BecsterAS/PowerLineSensorPCB/PowerLineSensorPCB.kicad_pcb

## KiCad design PowerLineSensorPCB.kicad_pcb (2026-07-15)

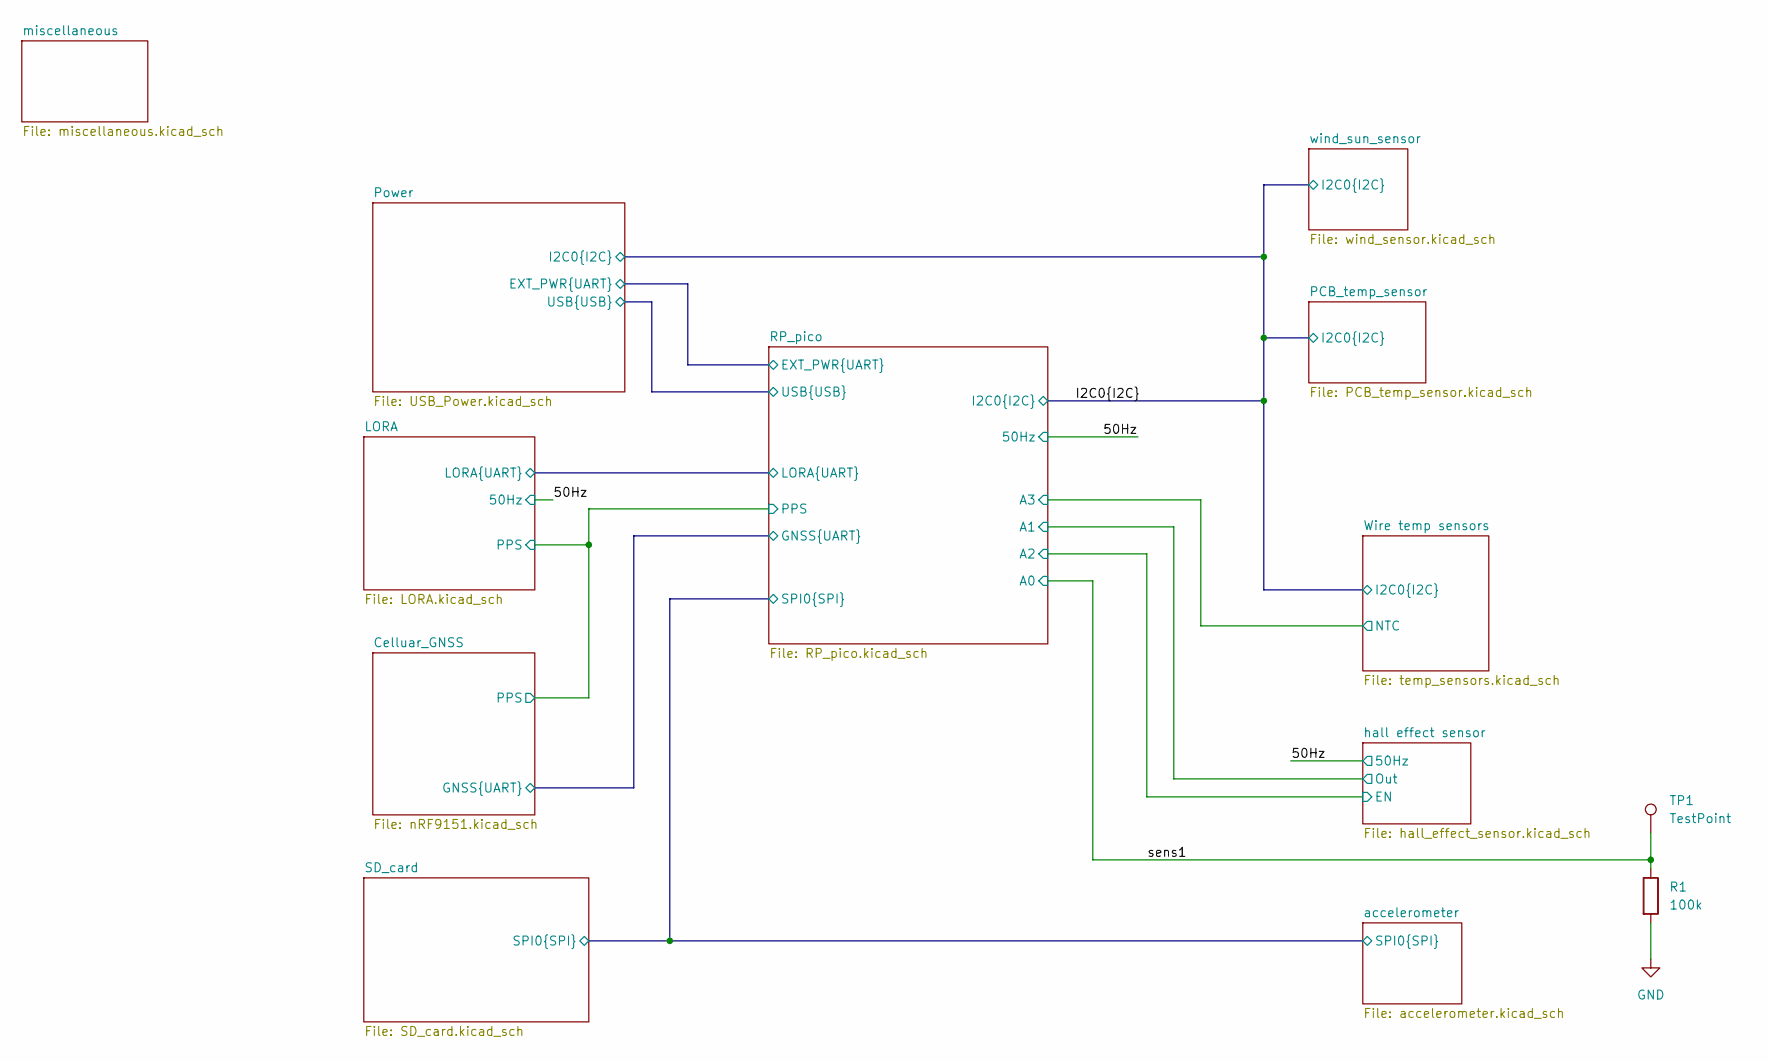
[picture p1: schematic PowerLineSensorPCB.kicad_sch]

Parts:
R1: 100k; R_0402_1005Metric; PartNumber 0402WGF1003TCE
TP1: TestPoint; TestPoint_Pad_D1.0mm

Connections:
/sens1: R1.1, TP1.1 (1_1); also elsewhere on the board
GND: R1.2; also elsewhere on the board

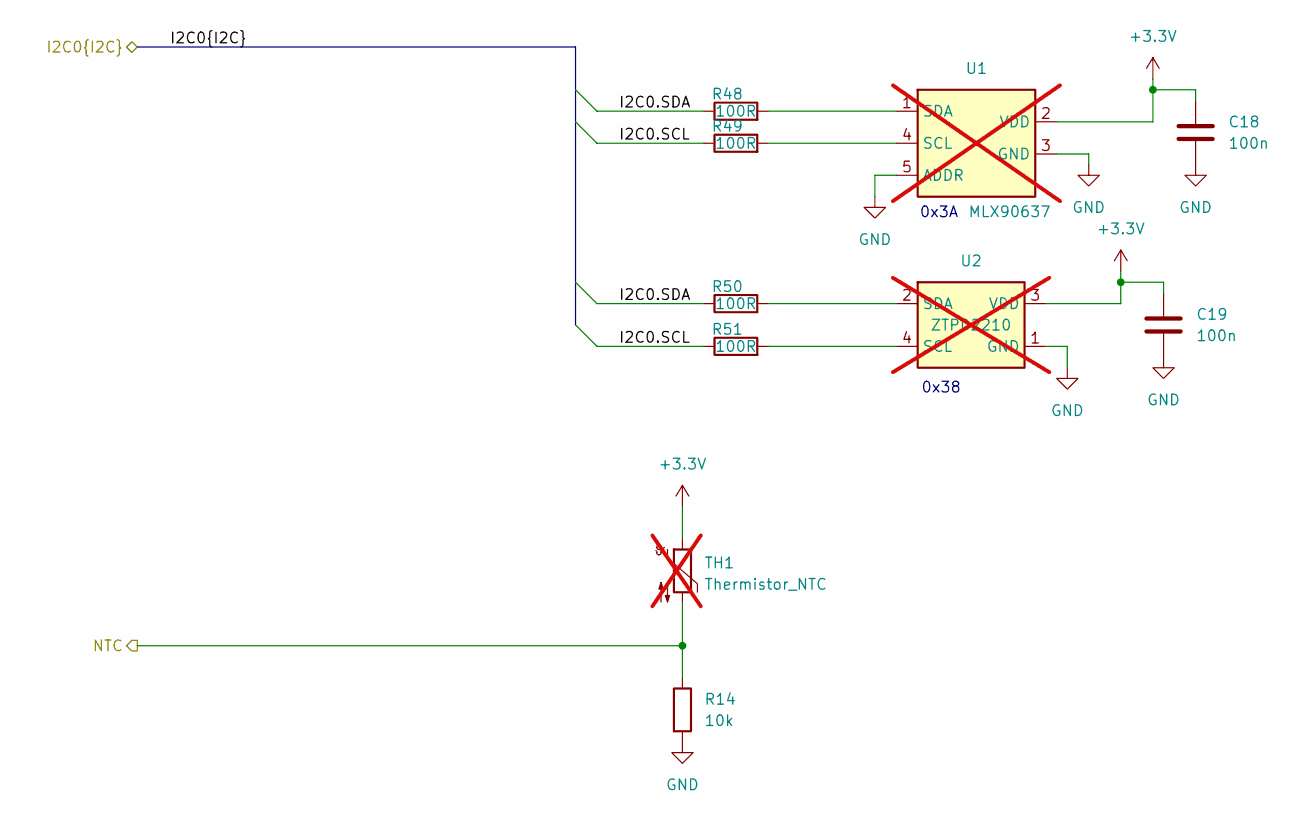
[picture p2: schematic temp_sensors.kicad_sch]

Parts:
C18, C19: 100n; C_0402_1005Metric; PartNumber CL05B104KO5NNNC
R14: 10k; R_0402_1005Metric; PartNumber 0402WGF1002TCE
R48, R49, R50, R51: 100R; R_0402_1005Metric; PartNumber 0402WGF1000TCE
TH1: Thermistor_NTC; R_Axial_DIN0204_L3.6mm_D1.6mm_P2.54mm_Vertical; not fitted
U1: MLX90637; PartNumber MLX90637; not fitted
U2: ZTPD2210; PartNumber ZTPD2210; not fitted

Connections:
+3.3V: C18.1, C19.1, TH1.1, U1.2 (VDD), U2.3 (VDD); also elsewhere on the board
/I2C0.SCL: R49.1, R51.1; also elsewhere on the board
/I2C0.SDA: R48.1, R50.1; also elsewhere on the board
/RP_pico/A3: R14.1, TH1.2; also elsewhere on the board
GND: C18.2, C19.2, R14.2, U1.3 (GND), U1.5 (ADDR), U1.6 (GND), U2.1 (GND); also elsewhere on the board
unnamed: R49.2, U1.4 (SCL)
unnamed: R48.2, U1.1 (SDA)
unnamed: R51.2, U2.4 (SCL)
unnamed: R50.2, U2.2 (SDA)

Notes on the sheet:
0x38
0x3A

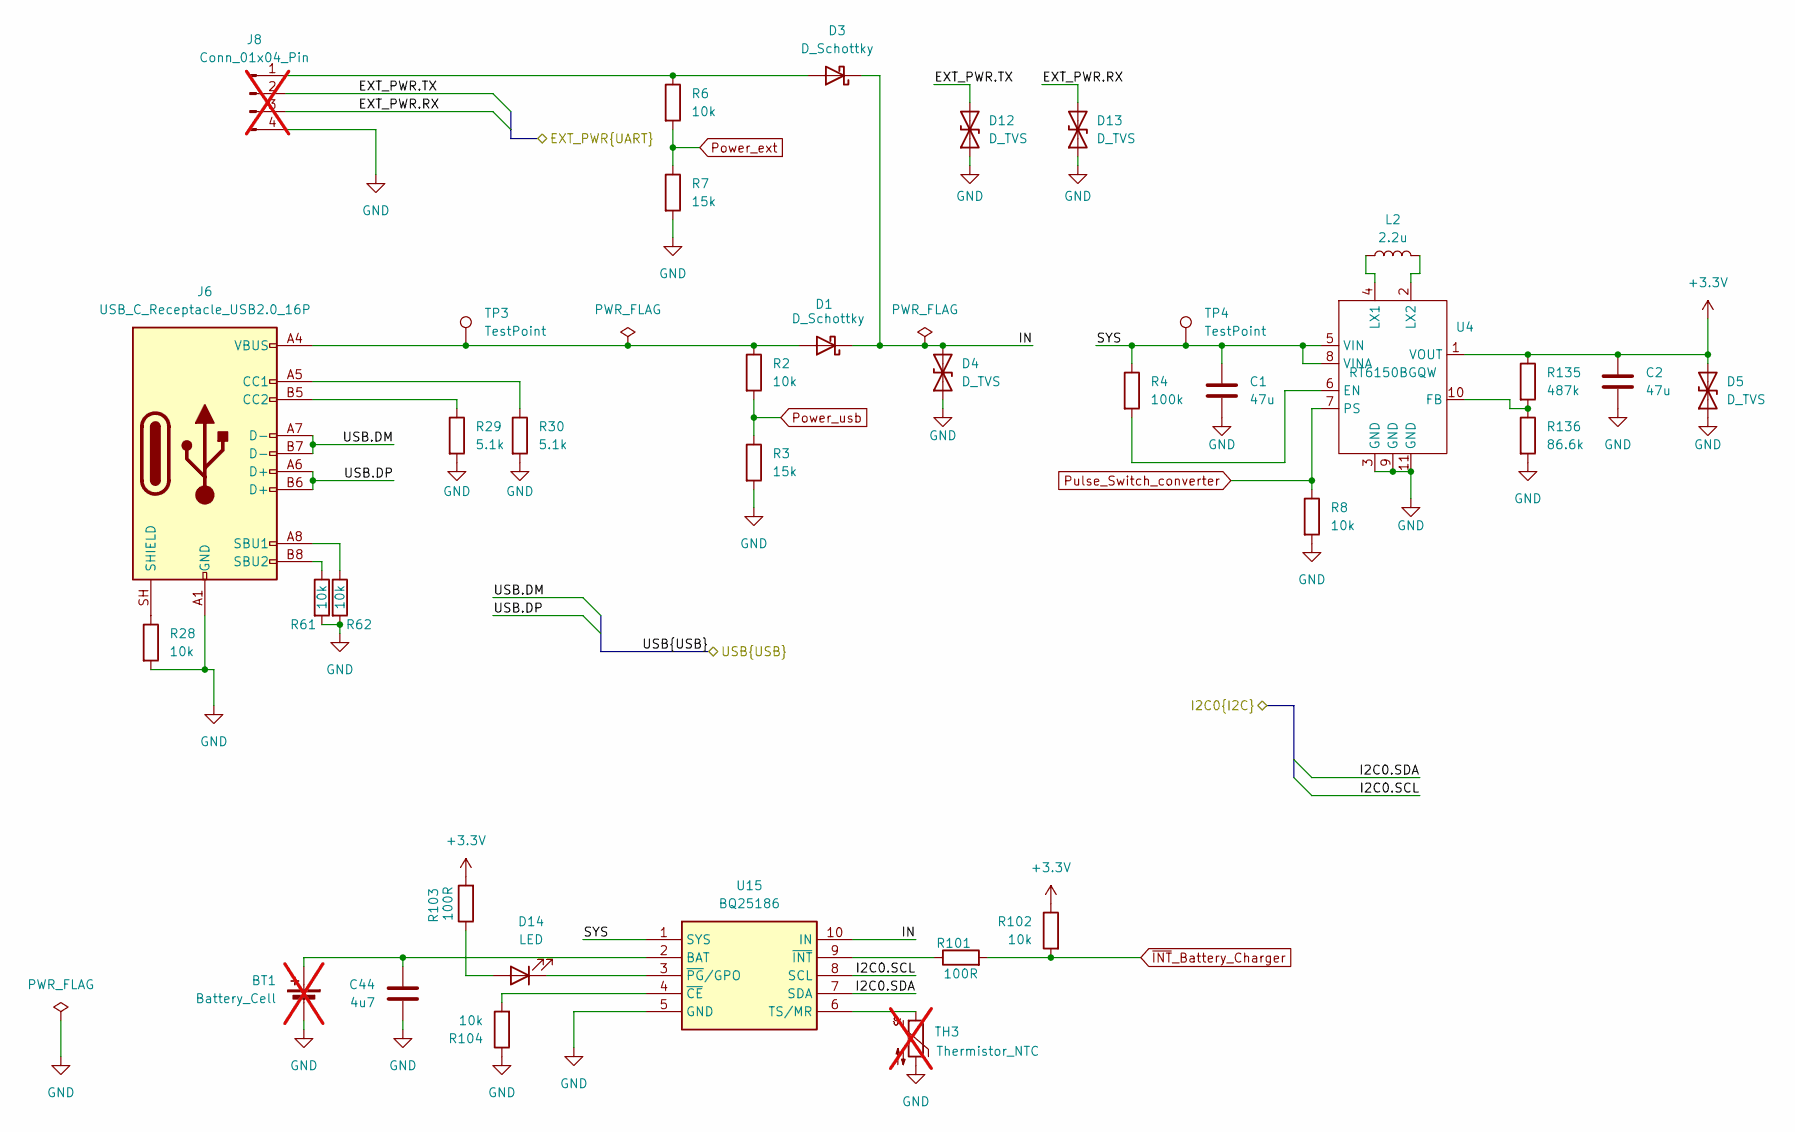
[picture p3: schematic USB_Power.kicad_sch]

Parts:
BT1: Battery_Cell; BatteryHolder_MPD_BH-18650-PC; PartNumber BH-18650-PC; not fitted
C1, C2: 47u; C_1206_3216Metric; PartNumber CL31A476MPHNNNE
C44: 4u7; C_0402_1005Metric; PartNumber CL05A475MP5NRNC
D1, D3: D_Schottky; D_SMA; PartNumber SS210
D4: D_TVS; D_SMB; PartNumber P6SMB6.8CA/TR13
D5, D12, D13: D_TVS; D_SOD-882; PartNumber PESD5V0C1ULS-QYL
D14: LED; D_0603_1608Metric; PartNumber KT-0603R
J6: USB_C_Receptacle_USB2.0_16P; USB_C_Receptacle_HRO_TYPE-C-31-M-12; PartNumber TYPE-C-31-M-12
J8: Conn_01x04_Pin; PinHeader_1x04_P2.54mm_Vertical; not fitted
L2: 2.2u; L_Murata_C2046258; PartNumber LQH3NPZ2R2MMEL
R2, R6, R8, R28, R61, R62, R102, R104: 10k; R_0402_1005Metric; PartNumber 0402WGF1002TCE
R3, R7: 15k; R_0402_1005Metric; PartNumber 0402WGF1502TCE
R4: 100k; R_0402_1005Metric; PartNumber 0402WGF1003TCE
R29, R30: 5.1k; R_0402_1005Metric; PartNumber 0402WGF5101TCE
R101, R103: 100R; R_0402_1005Metric; PartNumber 0402WGF1000TCE
R135: 487k; R_0402_1005Metric; PartNumber ERJ2RKF4873X
R136: 86.6k; R_0402_1005Metric; PartNumber ERA-2AEB8662X
TH3: Thermistor_NTC; R_0603_1608Metric_Pad0.98x0.95mm_HandSolder; not fitted
TP3, TP4: TestPoint; TestPoint_Pad_D1.0mm
U4: RT6150BGQW; WDFN-10-1EP_3x3mm_P0.5mm_EP1.8x2.5mm; PartNumber RT6150BGQW
U15: BQ25186; BQ25186DLHR_SON40P220X200X80-11N; PartNumber BQ25186DLHR; Mouser Part Number 595-BQ25186DLHR

Connections:
+3.3V: C2.1, D5.2 (A2), R102.1, R103.2, R135.1, U4.1 (VOUT); also elsewhere on the board
/I2C0.SCL: U15.8 (SCL); also elsewhere on the board
/I2C0.SDA: U15.7 (SDA); also elsewhere on the board
/Power/EXT_PWR.RX: D13.2 (A2), J8.3; also elsewhere on the board
/Power/EXT_PWR.TX: D12.2 (A2), J8.2; also elsewhere on the board
/Power/IN: D1.1 (K), D3.1 (K), D4.2 (A2), U15.10 (IN)
/Power/SYS: C1.1, R4.1, TP4.1 (1_1), U4.5 (VIN), U4.8 (VINA), U15.1 (SYS)
/Power/USB.DM: J6.A7 (D-), J6.B7 (D-); also elsewhere on the board
/Power/USB.DP: J6.A6 (D+), J6.B6 (D+); also elsewhere on the board
GND: BT1.2 (-), C1.2, C2.2, C44.2, D4.1 (A1), D5.1 (A1), D12.1 (A1), D13.1 (A1), J6.A1 (GND), J6.A12 (GND), J6.B1 (GND), J6.B12 (GND), J8.4, R3.2, R7.2, R8.2, R28.2, R29.2, R30.2, R61.2, R62.2, R104.1, R136.2, TH3.2, U4.3 (GND), U4.9 (GND), U4.11 (GND), U15.5 (GND), U15.11 (GND); also elsewhere on the board
unnamed: BT1.1 (+), C44.1, U15.2 (BAT)
unnamed: D1.2 (A), J6.A4 (VBUS), J6.A9 (VBUS), J6.B4 (VBUS), J6.B9 (VBUS), R2.1, TP3.1 (1_1)
unnamed: D3.2 (A), J8.1, R6.1
unnamed: D14.2 (A), R103.1
unnamed: D14.1 (K), U15.3 (~PG/GPO)
unnamed: J6.A5 (CC1), R30.1
unnamed: J6.B5 (CC2), R29.1
unnamed: J6.A8 (SBU1), R62.1
unnamed: J6.B8 (SBU2), R61.1
unnamed: J6.SH (SHIELD), R28.1
unnamed: R4.2, U4.6 (EN)
unnamed: R135.2, R136.1, U4.10 (FB)
unnamed: L2.1, U4.4 (LX1)
unnamed: L2.2, U4.2 (LX2)
unnamed: TH3.1, U15.6 (TS/MR)
unnamed: R104.2, U15.4 (~CE)
unnamed: R101.1, U15.9 (~INT)
Power_ext: R6.2, R7.1; also elsewhere on the board
Power_usb: R2.2, R3.1; also elsewhere on the board
Pulse_Switch_converter: R8.1, U4.7 (PS); also elsewhere on the board
~INT_Battery_Charger: R101.2, R102.2; also elsewhere on the board

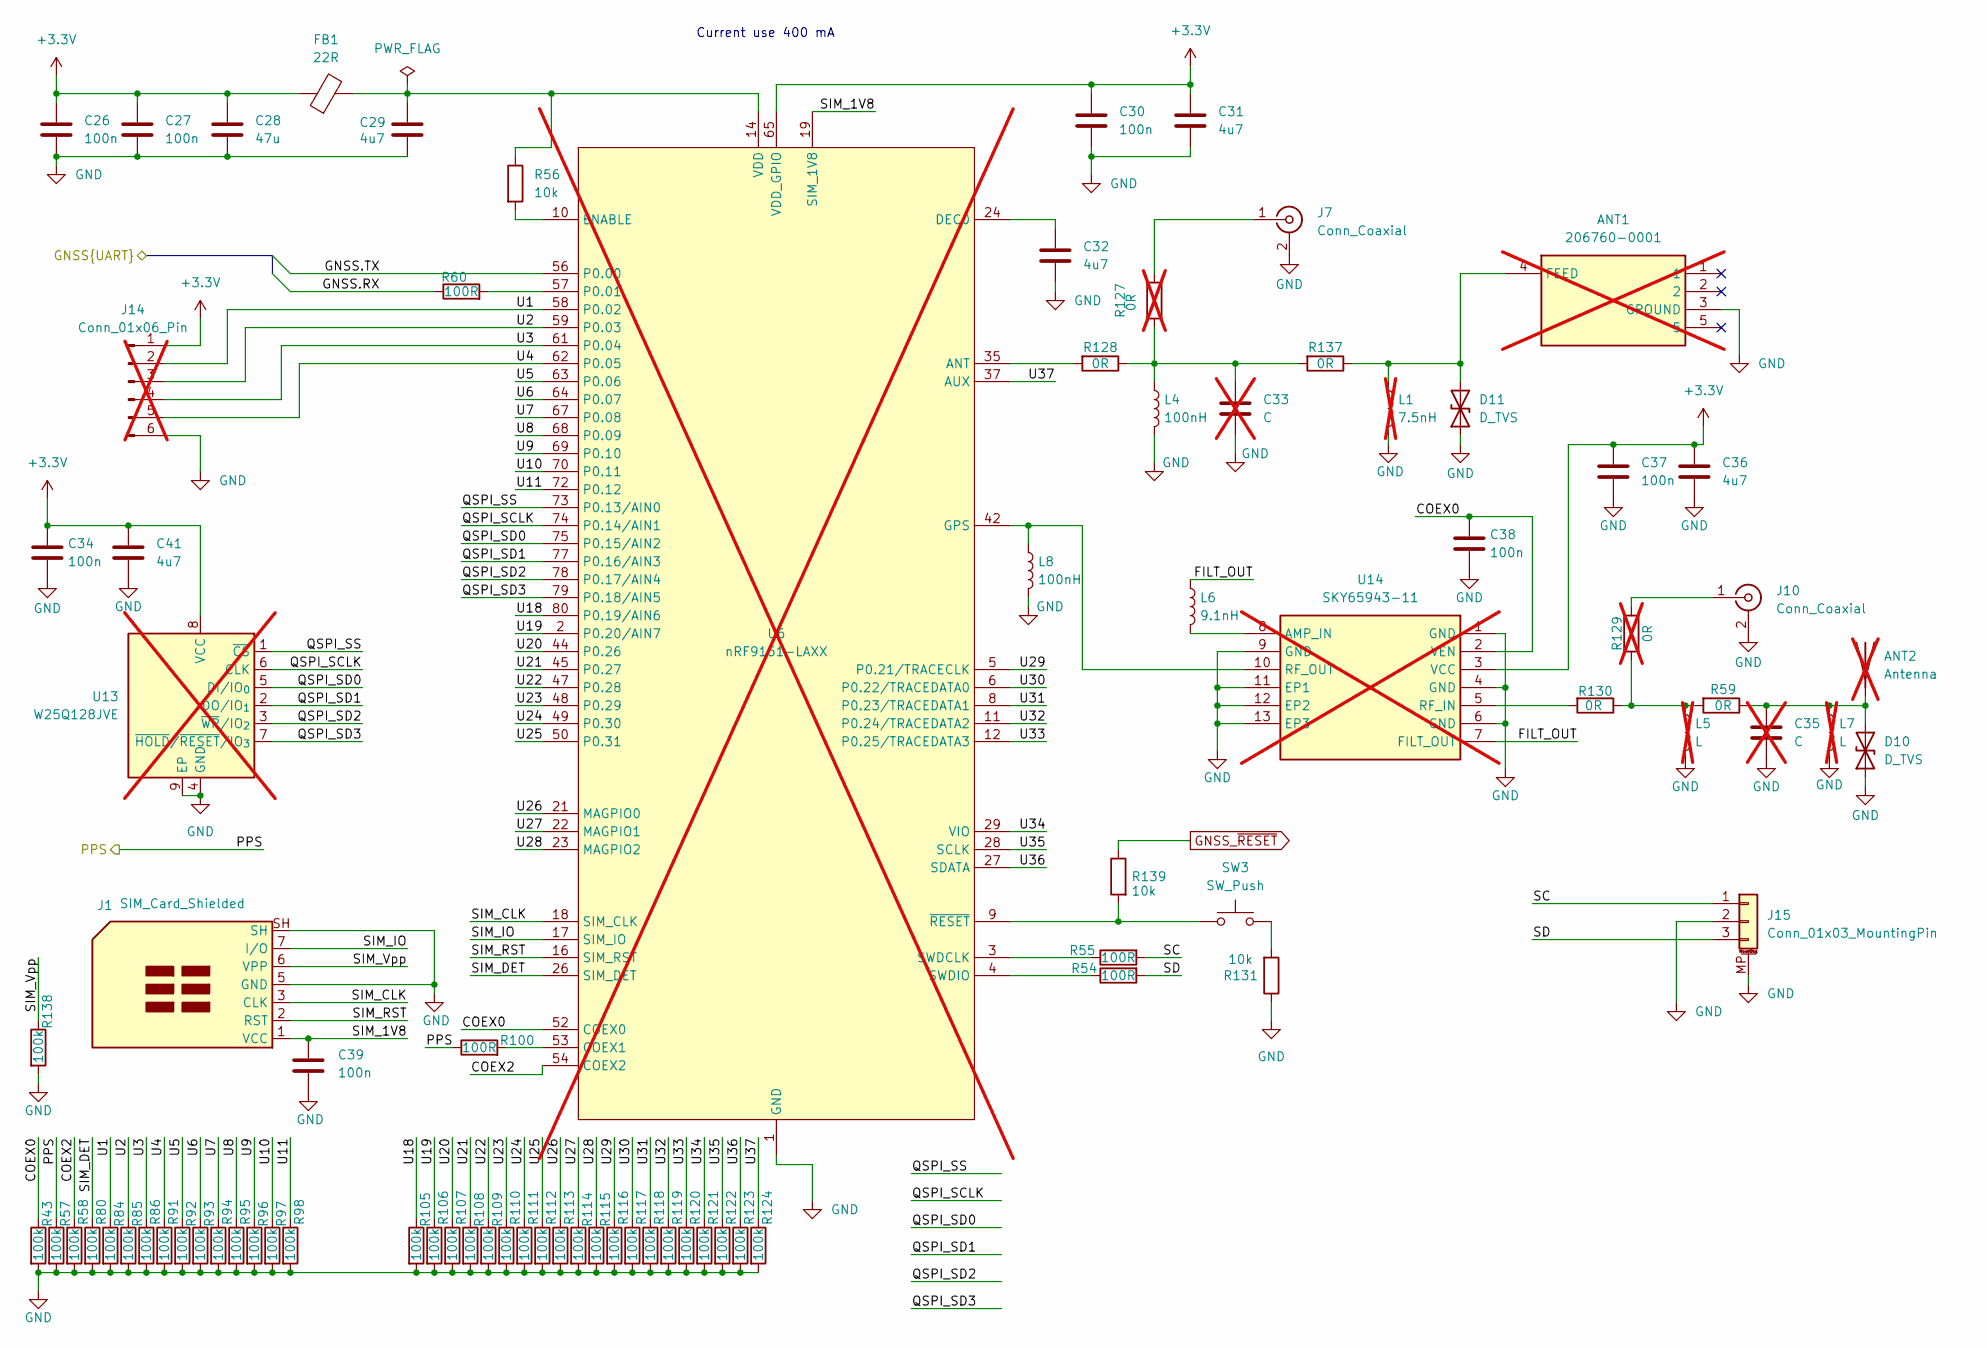
[picture p4: schematic nRF9151.kicad_sch]

Parts:
ANT1: 206760-0001; 2067600001; Mouser Part Number 538-206760-0001; not fitted
ANT2: Antenna; W3216; PartNumber W3216; not fitted
C26, C27, C30, C34, C37, C38, C39: 100n; C_0402_1005Metric; PartNumber CL05B104KO5NNNC
C28: 47u; C_1206_3216Metric; PartNumber CL31A476MPHNNNE
C29, C31, C32, C36, C41: 4u7; C_0402_1005Metric; PartNumber CL05A475MP5NRNC
C33, C35: C; C_0402_1005Metric; not fitted
D10, D11: D_TVS; Texas_DPY0002A_0.6x1mm_P0.65mm; PartNumber ESD701DPYR
FB1: 22R; L_0603_1608Metric; PartNumber BLM18SD220SN1D
J1: SIM_Card_Shielded; nanoSIM_GCT_SIM8060-6-0-14-00; PartNumber SIM8060-6-0-14-00-A
J7, J10: Conn_Coaxial; U.FL_Hirose_U.FL-R-SMT-1_Vertical; PartNumber BWU.FL-IPEX1
J14: Conn_01x06_Pin; PinHeader_1x06_P1.00mm_Vertical; not fitted
J15: Conn_01x03_MountingPin; JST_SH_BM03B-SRSS-TB_1x03-1MP_P1.00mm_Vertical; PartNumber BM03B-SRSS-TB(LF)(SN)
L1: 7.5nH; L_0402_1005Metric; not fitted
L4, L8: 100nH; L_0402_1005Metric; PartNumber LQW15ANR10J00D
L5, L7: L; L_0402_1005Metric; not fitted
L6: 9.1nH; L_0402_1005Metric; PartNumber LQW15AN9N1J00D
R43, R57, R58, R80, R84, R85, R86, R91, R92, R93, R94, R95, R96, R97, R98, R105, R106, R107, R108, R109, R110, R111, R112, R113, R114, R115, R116, R117, R118, R119, R120, R121, R122, R123, R124, R138: 100k; R_0402_1005Metric; PartNumber 0402WGF1003TCE
R54, R55, R60, R100: 100R; R_0402_1005Metric; PartNumber 0402WGF1000TCE
R56, R131, R139: 10k; R_0402_1005Metric; PartNumber 0402WGF1002TCE
R59, R128, R130, R137: 0R; R_0402_1005Metric; PartNumber 0402WGF0000TCE
R127, R129: 0R; R_0402_1005Metric; not fitted
SW3: SW_Push; SW_SPST_EVQP2_ShortPushTravel_H2.1mm; PartNumber EVQP2T02M
U6: nRF9151-LAXX; LGA_9151_12.1x11.1mm; PartNumber nRF9151-A1; not fitted
U13: W25Q128JVE; W25Q; PartNumber W25Q128JVEIM; not fitted
U14: SKY65943-11; SKY6594311; Mouser Part Number 873-SKY65943-11; not fitted

Connections:
+3.3V: C26.1, C27.1, C28.1, C30.1, C31.1, C34.1, C36.1, C37.1, C41.1, FB1.1, J14.1, U6.65 (VDD_GPIO), U13.8 (VCC), U14.3 (VCC); also elsewhere on the board
/Celluar_GNSS/COEX0: C38.1, R43.1, U6.52 (COEX0), U14.2 (VEN)
/Celluar_GNSS/COEX2: R58.1, U6.54 (COEX2)
/Celluar_GNSS/FILT_OUT: L6.1, U14.7 (FILT_OUT)
/Celluar_GNSS/GNSS.RX: R60.1; also elsewhere on the board
/Celluar_GNSS/GNSS.TX: U6.56 (P0.00); also elsewhere on the board
/Celluar_GNSS/PPS: R57.1, R100.1; also elsewhere on the board
/Celluar_GNSS/QSPI_SCLK: U6.74 (P0.14/AIN1), U13.6 (CLK)
/Celluar_GNSS/QSPI_SD0: U6.75 (P0.15/AIN2), U13.5 (DI/IO_{0})
/Celluar_GNSS/QSPI_SD1: U6.77 (P0.16/AIN3), U13.2 (DO/IO_{1})
/Celluar_GNSS/QSPI_SD2: U6.78 (P0.17/AIN4), U13.3 (~WP/IO_{2})
/Celluar_GNSS/QSPI_SD3: U6.79 (P0.18/AIN5), U13.7 (~HOLD/~RESET/IO_{3})
/Celluar_GNSS/QSPI_SS: U6.73 (P0.13/AIN0), U13.1 (~CS)
/Celluar_GNSS/SC: J15.1, R55.2
/Celluar_GNSS/SD: J15.3, R54.2
/Celluar_GNSS/SIM_1V8: C39.1, J1.1 (VCC), U6.19 (SIM_1V8)
/Celluar_GNSS/SIM_CLK: J1.3 (CLK), U6.18 (SIM_CLK)
/Celluar_GNSS/SIM_DET: R80.1, U6.26 (SIM_DET)
/Celluar_GNSS/SIM_IO: J1.7 (I/O), U6.17 (SIM_IO)
/Celluar_GNSS/SIM_RST: J1.2 (RST), U6.16 (SIM_RST)
/Celluar_GNSS/SIM_Vpp: J1.6 (VPP), R138.1
/Celluar_GNSS/U1: J14.2, R84.1, U6.58 (P0.02)
/Celluar_GNSS/U2: J14.3, R85.1, U6.59 (P0.03)
/Celluar_GNSS/U3: J14.4, R86.1, U6.61 (P0.04)
/Celluar_GNSS/U4: J14.5, R91.1, U6.62 (P0.05)
/Celluar_GNSS/U5: R92.1, U6.63 (P0.06)
/Celluar_GNSS/U6: R93.1, U6.64 (P0.07)
/Celluar_GNSS/U7: R94.1, U6.67 (P0.08)
/Celluar_GNSS/U8: R95.1, U6.68 (P0.09)
/Celluar_GNSS/U9: R96.1, U6.69 (P0.10)
/Celluar_GNSS/U10: R97.1, U6.70 (P0.11)
/Celluar_GNSS/U11: R98.1, U6.72 (P0.12)
/Celluar_GNSS/U18: R105.1, U6.80 (P0.19/AIN6)
/Celluar_GNSS/U19: R106.1, U6.2 (P0.20/AIN7)
/Celluar_GNSS/U20: R107.1, U6.44 (P0.26)
/Celluar_GNSS/U21: R108.1, U6.45 (P0.27)
/Celluar_GNSS/U22: R109.1, U6.47 (P0.28)
/Celluar_GNSS/U23: R110.1, U6.48 (P0.29)
/Celluar_GNSS/U24: R111.1, U6.49 (P0.30)
/Celluar_GNSS/U25: R112.1, U6.50 (P0.31)
/Celluar_GNSS/U26: R113.1, U6.21 (MAGPIO0)
/Celluar_GNSS/U27: R114.1, U6.22 (MAGPIO1)
/Celluar_GNSS/U28: R115.1, U6.23 (MAGPIO2)
/Celluar_GNSS/U29: R116.1, U6.5 (P0.21/TRACECLK)
/Celluar_GNSS/U30: R117.1, U6.6 (P0.22/TRACEDATA0)
/Celluar_GNSS/U31: R118.1, U6.8 (P0.23/TRACEDATA1)
/Celluar_GNSS/U32: R119.1, U6.11 (P0.24/TRACEDATA2)
/Celluar_GNSS/U33: R120.1, U6.12 (P0.25/TRACEDATA3)
/Celluar_GNSS/U34: R121.1, U6.29 (VIO)
/Celluar_GNSS/U35: R122.1, U6.28 (SCLK)
/Celluar_GNSS/U36: R123.1, U6.27 (SDATA)
/Celluar_GNSS/U37: R124.1, U6.37 (AUX)
GND: ANT1.3 (GROUND), C26.2, C27.2, C28.2, C29.2, C30.2, C31.2, C32.2, C33.2, C34.2, C35.2, C36.2, C37.2, C38.2, C39.2, C41.2, D10.1 (A1), D11.1 (A1), J1.5 (GND), J1.SH, J7.2 (Ext), J10.2 (Ext), J14.6, J15.2, J15.MP (MountPin), L1.2, L4.2, L5.2, L7.2, L8.2, R43.2, R57.2, R58.2, R80.2, R84.2, R85.2, R86.2, R91.2, R92.2, R93.2, R94.2, R95.2, R96.2, R97.2, R98.2, R105.2, R106.2, R107.2, R108.2, R109.2, R110.2, R111.2, R112.2, R113.2, R114.2, R115.2, R116.2, R117.2, R118.2, R119.2, R120.2, R121.2, R122.2, R123.2, R124.2, R131.1, R138.2, U6.1 (GND), U6.7 (GND), U6.13 (GND), U6.15 (GND), U6.20 (GND), U6.25 (GND), U6.30 (GND), U6.34 (GND), U6.36 (GND), U6.38 (GND), U6.39 (GND), U6.40 (GND), U6.41 (GND), U6.43 (GND), U6.46 (GND), U6.51 (GND), U6.55 (GND), U6.60 (GND), U6.66 (GND), U6.71 (GND), U6.76 (GND), U6.105 (GND), U6.106 (GND), U6.107 (GND), U6.108 (GND), U6.109 (GND), U6.110 (GND), U6.111 (GND), U6.112 (GND), U6.113 (GND), U13.4 (GND), U13.9 (EP), U14.1 (GND), U14.4 (GND), U14.6 (GND), U14.9 (GND), U14.11 (EP1), U14.12 (EP2), U14.13 (EP3); also elsewhere on the board
GNSS_~RESET: R139.1; also elsewhere on the board
unnamed: ANT1.4 (FEED), D11.2 (A2), L1.1, R137.1
unnamed: ANT2.1 (A_1), C35.1, D10.2 (A2), L7.1, R59.1
unnamed: C33.1, L4.1, R127.2, R128.1, R137.2
unnamed: J7.1 (In), R127.1
unnamed: J10.1 (In), R129.1
unnamed: L5.1, R59.2, R129.2, R130.1
unnamed: R131.2, SW3.2
unnamed: R128.2, U6.35 (ANT)
unnamed: R100.2, U6.53 (COEX1)
unnamed: C32.1, U6.24 (DEC0)
unnamed: R56.2, U6.10 (ENABLE)
unnamed: R60.2, U6.57 (P0.01)
unnamed: R55.1, U6.3 (SWDCLK)
unnamed: R54.1, U6.4 (SWDIO)
unnamed: C29.1, FB1.2, R56.1, U6.14 (VDD)
unnamed: R139.2, SW3.1, U6.9 (~RESET)
unnamed: L6.2, U14.8 (AMP_IN)
unnamed: R130.2, U14.5 (RF_IN)
unnamed: L8.1, U6.42 (GPS), U14.10 (RF_OUT)

Notes on the sheet:
Current use 400 mA

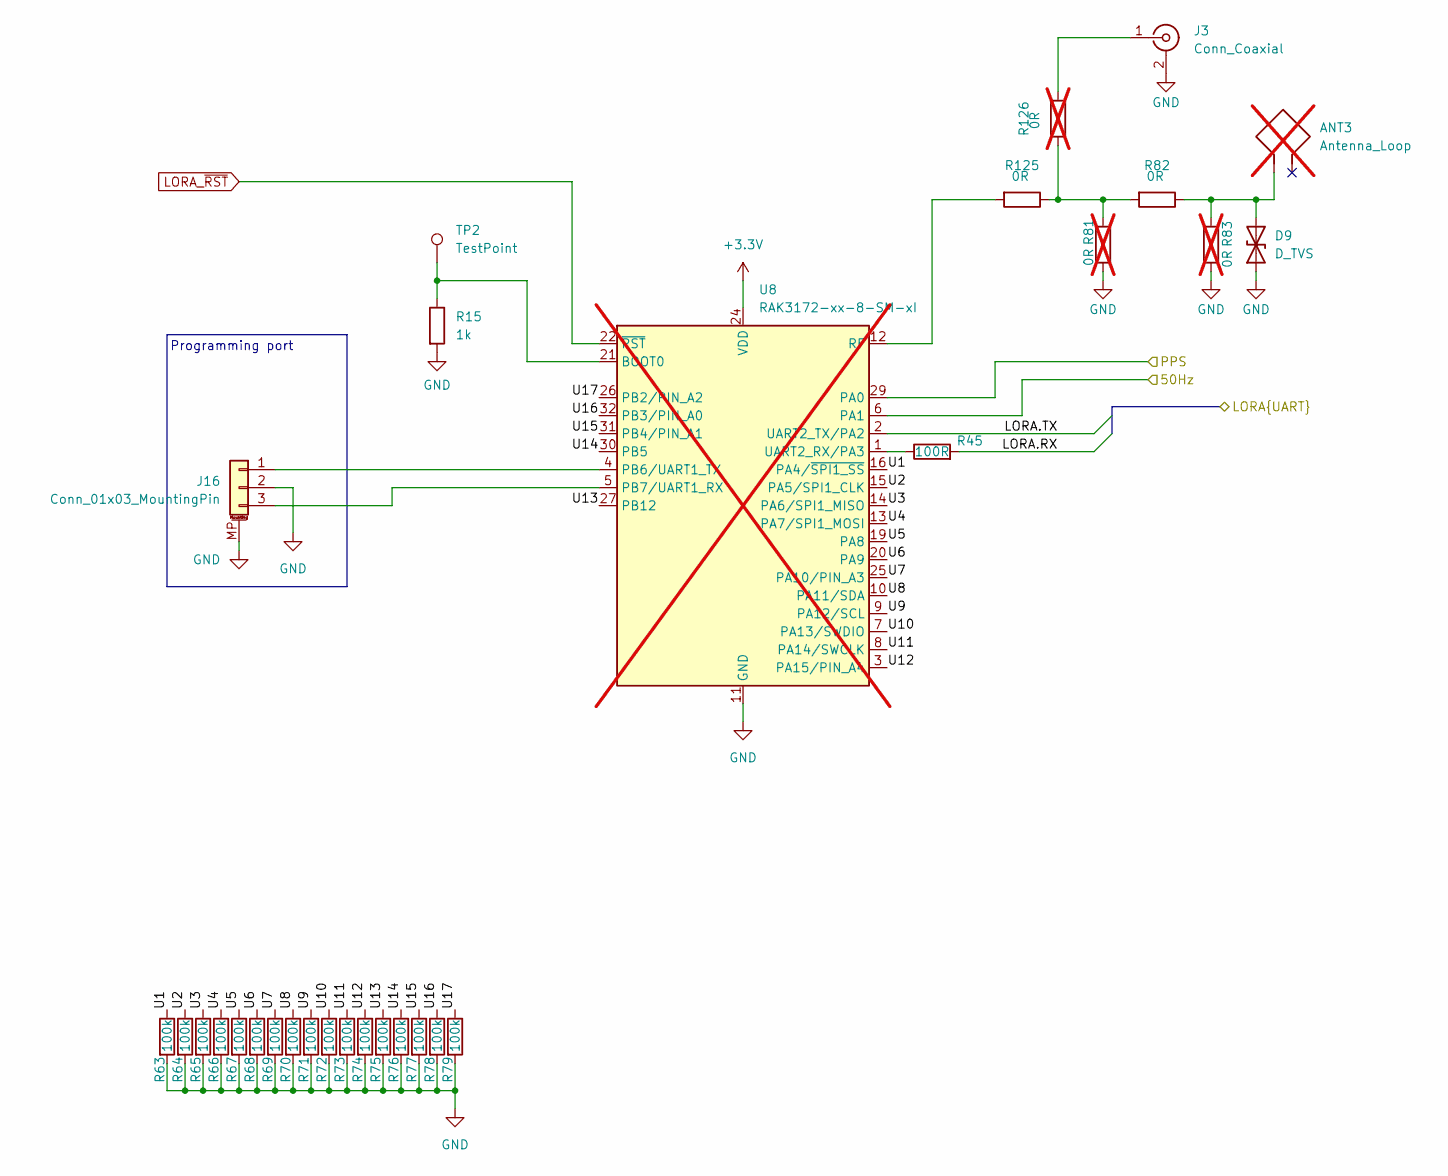
[picture p5: schematic LORA.kicad_sch]

Parts:
ANT3: Antenna_Loop; ANT-868-HESM; PartNumber ANT-868-HESM; not fitted
D9: D_TVS; Texas_DPY0002A_0.6x1mm_P0.65mm; PartNumber ESD701DPYR
J3: Conn_Coaxial; U.FL_Hirose_U.FL-R-SMT-1_Vertical; PartNumber BWU.FL-IPEX1
J16: Conn_01x03_MountingPin; JST_SH_BM03B-SRSS-TB_1x03-1MP_P1.00mm_Vertical; PartNumber BM03B-SRSS-TB(LF)(SN)
R15: 1k; R_0402_1005Metric; PartNumber 0402WGF1001TCE
R45: 100R; R_0402_1005Metric; PartNumber 0402WGF1000TCE
R63, R64, R65, R66, R67, R68, R69, R70, R71, R72, R73, R74, R75, R76, R77, R78, R79: 100k; R_0402_1005Metric; PartNumber 0402WGF1003TCE
R81, R83, R126: 0R; R_0402_1005Metric; not fitted
R82, R125: 0R; R_0402_1005Metric; PartNumber 0402WGF0000TCE
TP2: TestPoint; TestPoint_Pad_D1.0mm
U8: RAK3172-xx-8-SM-xI; RAK3172; PartNumber RAK3172-T-8-SM-NI; not fitted

Connections:
+3.3V: U8.24 (VDD); also elsewhere on the board
/50Hz: U8.6 (PA1); also elsewhere on the board
/Celluar_GNSS/PPS: U8.29 (PA0); also elsewhere on the board
/LORA/LORA.RX: R45.2; also elsewhere on the board
/LORA/LORA.TX: U8.2 (UART2_TX/PA2); also elsewhere on the board
/LORA/U1: R63.1, U8.16 (PA4/~SPI1_SS)
/LORA/U2: R64.1, U8.15 (PA5/SPI1_CLK)
/LORA/U3: R65.1, U8.14 (PA6/SPI1_MISO)
/LORA/U4: R66.1, U8.13 (PA7/SPI1_MOSI)
/LORA/U5: R67.1, U8.19 (PA8)
/LORA/U6: R68.1, U8.20 (PA9)
/LORA/U7: R69.1, U8.25 (PA10/PIN_A3)
/LORA/U8: R70.1, U8.10 (PA11/SDA)
/LORA/U9: R71.1, U8.9 (PA12/SCL)
/LORA/U10: R72.1, U8.7 (PA13/SWDIO)
/LORA/U11: R73.1, U8.8 (PA14/SWCLK)
/LORA/U12: R74.1, U8.3 (PA15/PIN_A4)
/LORA/U13: R75.1, U8.27 (PB12)
/LORA/U14: R76.1, U8.30 (PB5)
/LORA/U15: R77.1, U8.31 (PB4/PIN_A1)
/LORA/U16: R78.1, U8.32 (PB3/PIN_A0)
/LORA/U17: R79.1, U8.26 (PB2/PIN_A2)
GND: D9.1 (A1), J3.2 (Ext), J16.2, J16.MP (MountPin), R15.2, R63.2, R64.2, R65.2, R66.2, R67.2, R68.2, R69.2, R70.2, R71.2, R72.2, R73.2, R74.2, R75.2, R76.2, R77.2, R78.2, R79.2, R81.2, R83.1, U8.11 (GND), U8.17 (GND), U8.18 (GND), U8.23 (GND), U8.28 (GND); also elsewhere on the board
LORA_~RST: U8.22 (~RST); also elsewhere on the board
unnamed: ANT3.1, D9.2 (A2), R82.1, R83.2
unnamed: J3.1 (In), R126.1
unnamed: J16.1, U8.4 (PB6/UART1_TX)
unnamed: J16.3, U8.5 (PB7/UART1_RX)
unnamed: R81.1, R82.2, R125.1, R126.2
unnamed: R15.1, TP2.1 (1_1), U8.21 (BOOT0)
unnamed: R125.2, U8.12 (RF)
unnamed: R45.1, U8.1 (UART2_RX/PA3)

Notes on the sheet:
Programming port

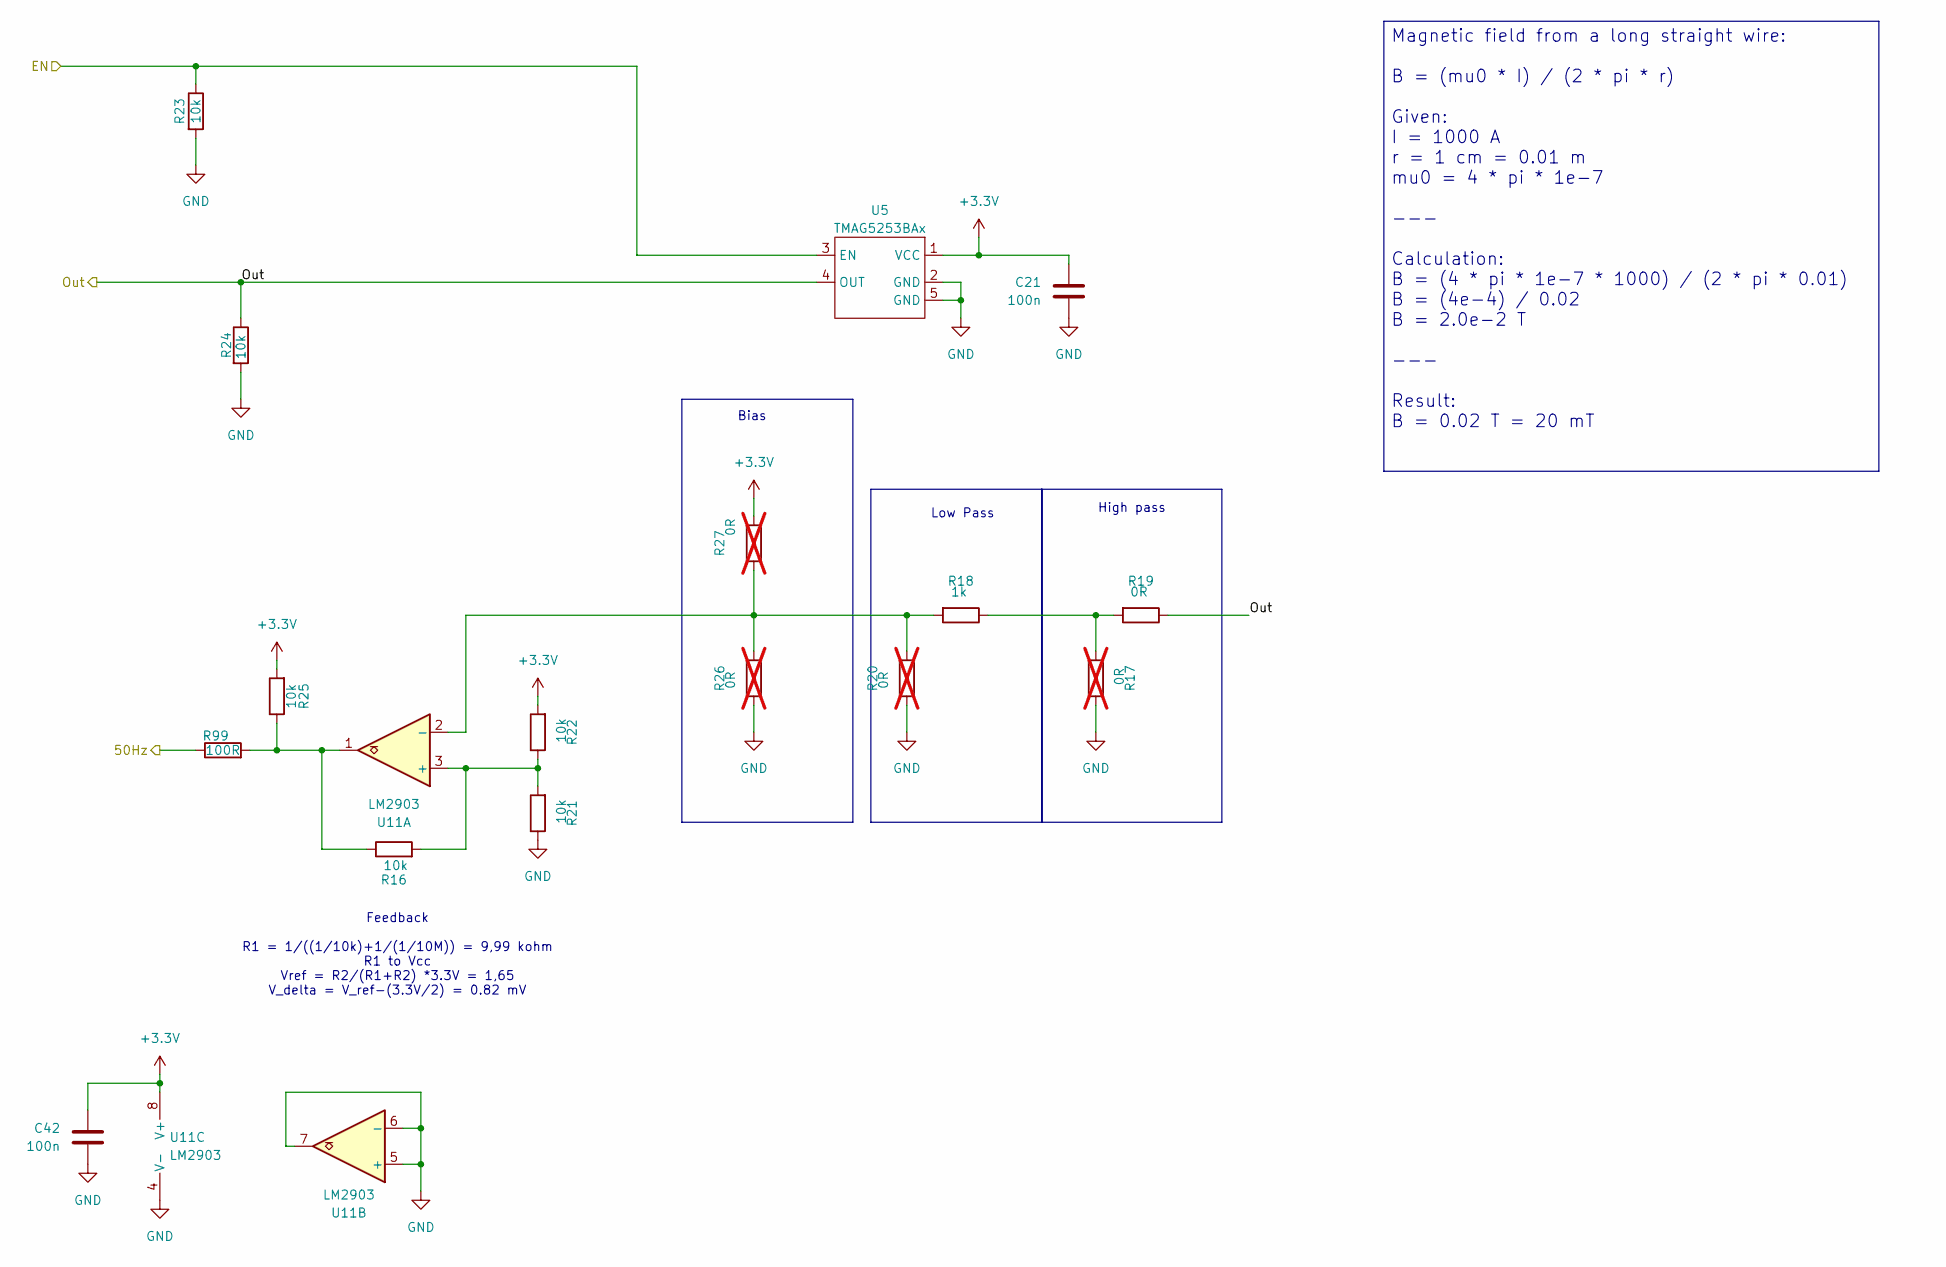
[picture p6: schematic hall_effect_sensor.kicad_sch]

Parts:
C21, C42: 100n; C_0402_1005Metric; PartNumber CL05B104KO5NNNC
R16, R21, R22, R23, R24, R25: 10k; R_0402_1005Metric; PartNumber 0402WGF1002TCE
R17, R20, R26, R27: 0R; R_0402_1005Metric; not fitted
R18: 1k; R_0402_1005Metric; PartNumber 0402WGF1001TCE
R19: 0R; R_0402_1005Metric; PartNumber 0402WGF0000TCE
R99: 100R; R_0402_1005Metric; PartNumber 0402WGF1000TCE
U5: TMAG5253BAx; Texas_X2SON-4-1EP_1.1x1.4mm_P0.5mm_EP0.8x0.6mm; PartNumber TMAG5253BA1
U11: LM2903; SOIC-8_3.9x4.9mm_P1.27mm; PartNumber LM2903DR

Connections:
+3.3V: C21.1, C42.1, R22.2, R25.2, R27.1, U5.1 (VCC), U11.8 (V+); also elsewhere on the board
/50Hz: R99.1; also elsewhere on the board
/RP_pico/A2: R23.1, U5.3 (EN); also elsewhere on the board
/hall effect sensor/Out: R19.1, R24.1, U5.4 (OUT); also elsewhere on the board
GND: C21.2, C42.2, R17.1, R20.2, R21.1, R23.2, R24.2, R26.2, U5.2 (GND), U5.5 (GND), U11.4 (V-), U11.5 (+), U11.6 (-), U11.7; also elsewhere on the board
unnamed: R16.1, R25.1, R99.2, U11.1
unnamed: R17.2, R18.1, R19.2
unnamed: R16.2, R21.2, R22.1, U11.3 (+)
unnamed: R18.2, R20.1, R26.1, R27.2, U11.2 (-)

Notes on the sheet:
Bias
High pass
Feedback R1 = 1/((1/10k)+1/(1/10M)) = 9,99 kohm R1 to Vcc Vref = R2/(R1+R2) *3.3V = 1,65 V_delta = V_ref-(3.3V/2) = 0.82 mV
Low Pass
Magnetic field from a long straight wire: B = (mu0 * I) / (2 * pi * r) Given: I = 1000 A r = 1 cm = 0.01 m mu0 = 4 * pi * 1e-7 --- Calculation: B = (4 * pi * 1e-7 * 1000) / (2 * pi * 0.01) B = (4e-4) / 0.02 B = 2.0e-2 T --- Result: B = 0.02 T = 20 mT

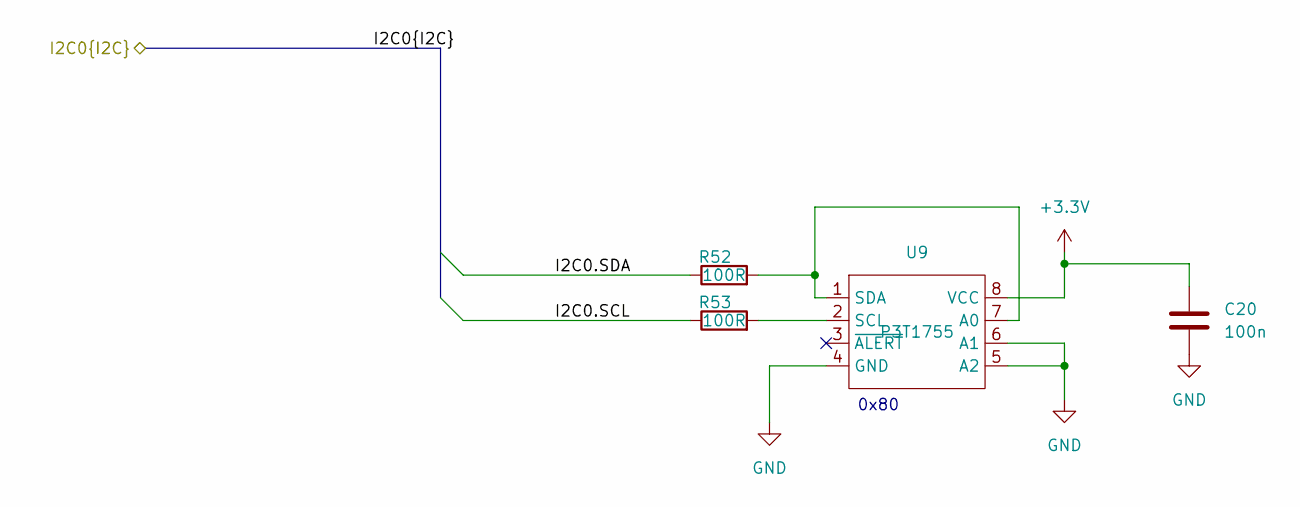
[picture p7: schematic PCB_temp_sensor.kicad_sch]

Parts:
C20: 100n; C_0402_1005Metric; PartNumber CL05B104KO5NNNC
R52, R53: 100R; R_0402_1005Metric; PartNumber 0402WGF1000TCE
U9: P3T1755; TSSOP-8_3x3mm_P0.65mm; PartNumber P3T1755 DP

Connections:
+3.3V: C20.1, U9.8 (VCC); also elsewhere on the board
/I2C0.SCL: R53.1; also elsewhere on the board
/I2C0.SDA: R52.1; also elsewhere on the board
GND: C20.2, U9.4 (GND), U9.5 (A2), U9.6 (A1); also elsewhere on the board
unnamed: R52.2, U9.1 (SDA), U9.7 (A0)
unnamed: R53.2, U9.2 (SCL)

Notes on the sheet:
0x80

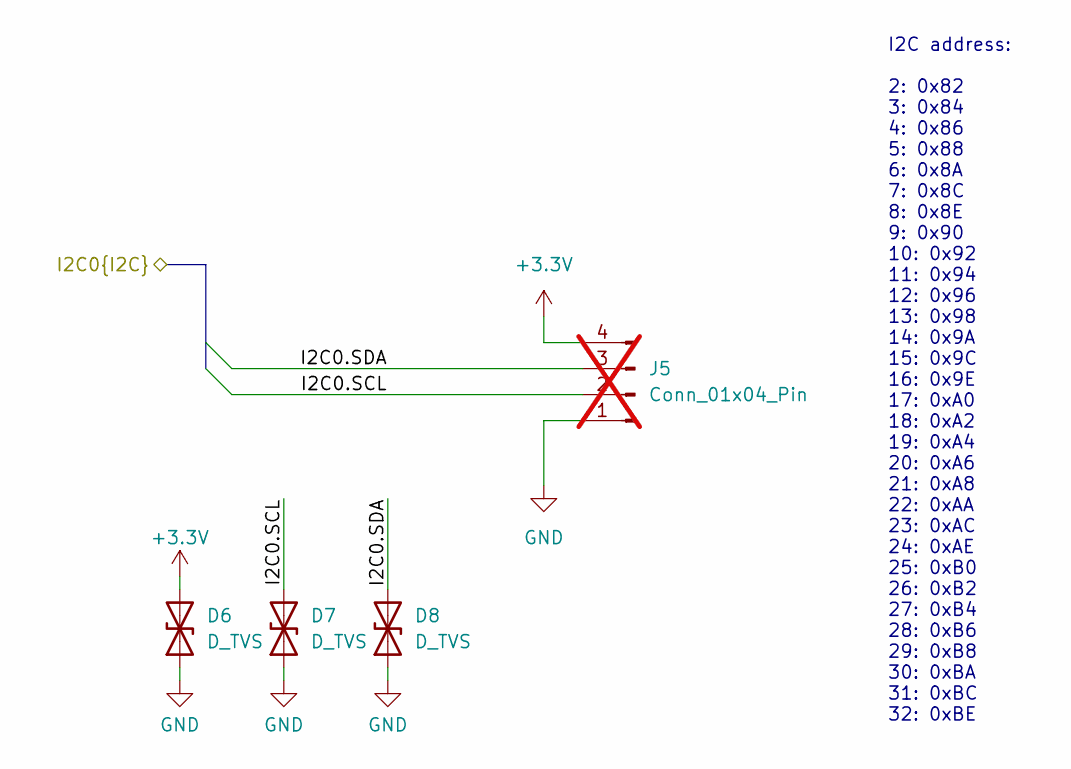
[picture p8: schematic wind_sensor.kicad_sch]

Parts:
D6, D7, D8: D_TVS; D_SOD-882; PartNumber PESD5V0C1ULS-QYL
J5: Conn_01x04_Pin; PinHeader_2x02_P2.54mm_Vertical; not fitted

Connections:
+3.3V: D6.2 (A2), J5.4; also elsewhere on the board
/I2C0.SCL: D7.2 (A2), J5.2; also elsewhere on the board
/I2C0.SDA: D8.2 (A2), J5.3; also elsewhere on the board
GND: D6.1 (A1), D7.1 (A1), D8.1 (A1), J5.1; also elsewhere on the board

Notes on the sheet:
I2C address: 2: 0x82 3: 0x84 4: 0x86 5: 0x88 6: 0x8A 7: 0x8C 8: 0x8E 9: 0x90 10: 0x92 11: 0x94 12: 0x96 13: 0x98 14: 0x9A 15: 0x9C 16: 0x9E 17: 0xA0 18: 0xA2 19: 0xA4 20: 0xA6 21: 0xA8 22: 0xAA 23: 0xAC 24: 0xAE 25: 0xB0 26: 0xB2 27: 0xB4 28: 0xB6 29: 0xB8 30: 0xBA 31: 0xBC 32: 0xBE
