BecsterAS/PowerLineSensorPCB/PowerLineSensorPCB.kicad_pcb

## KiCad design PowerLineSensorPCB.kicad_pcb (continued)

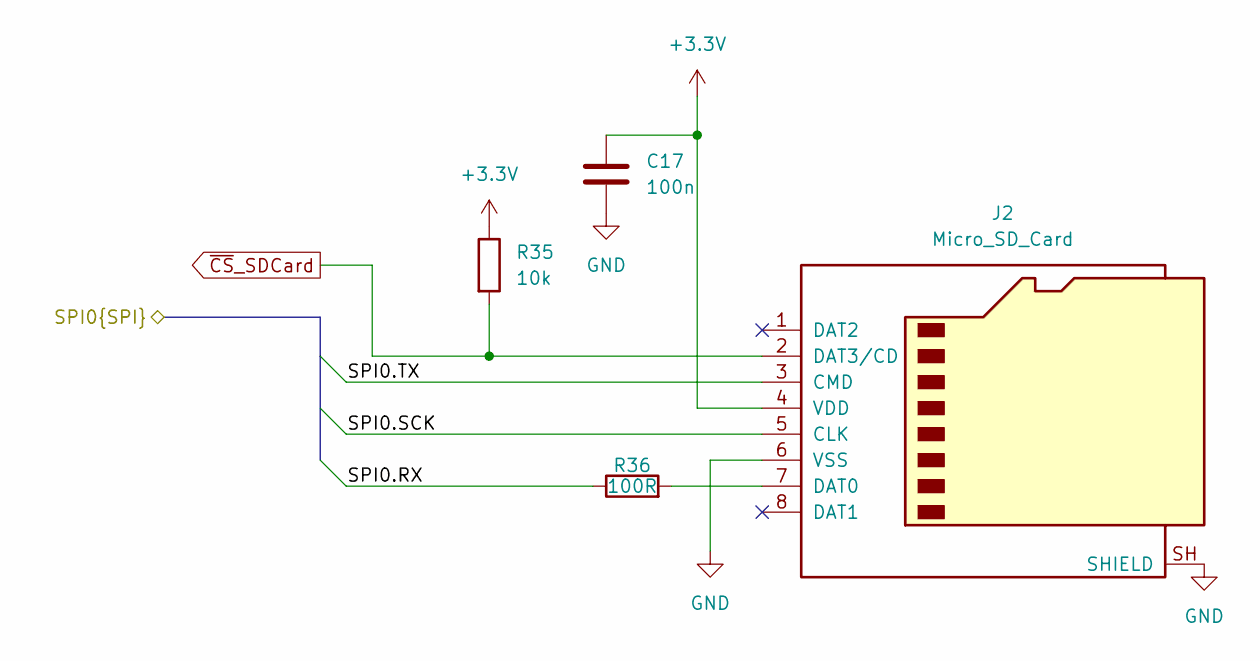
[picture p9: schematic SD_card.kicad_sch]

Parts:
C17: 100n; C_0402_1005Metric; PartNumber CL05B104KO5NNNC
J2: Micro_SD_Card; microSD_HC_Molex_47219-2001; PartNumber 472192001
R35: 10k; R_0402_1005Metric; PartNumber 0402WGF1002TCE
R36: 100R; R_0402_1005Metric; PartNumber 0402WGF1000TCE

Connections:
+3.3V: C17.1, J2.4 (VDD), R35.1; also elsewhere on the board
/RP_pico/SPI0.RX: R36.1; also elsewhere on the board
/RP_pico/SPI0.SCK: J2.5 (CLK); also elsewhere on the board
/RP_pico/SPI0.TX: J2.3 (CMD); also elsewhere on the board
GND: C17.2, J2.6 (VSS), J2.SH (SHIELD); also elsewhere on the board
unnamed: J2.7 (DAT0), R36.2
~CS_SDCard: J2.2 (DAT3/CD), R35.2; also elsewhere on the board

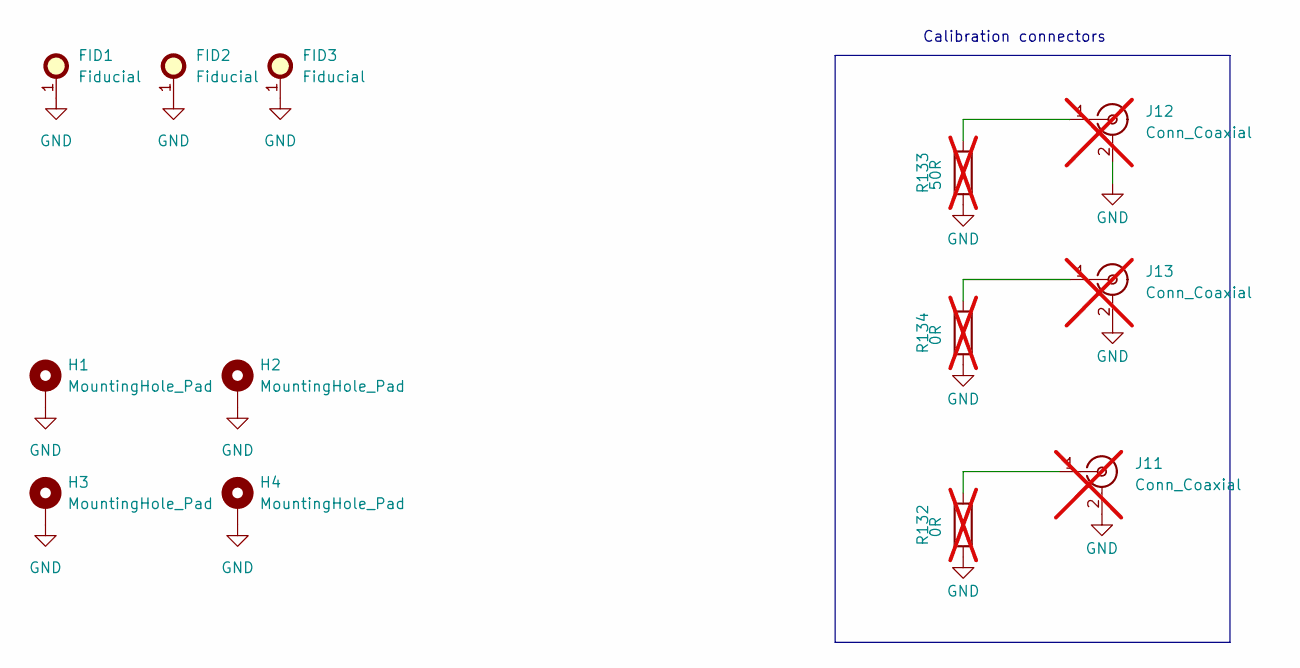
[picture p10: schematic miscellaneous.kicad_sch]

Parts:
FID1, FID2, FID3: Fiducial; Fiducial_0.75mm_Mask1.5mm
H1, H2, H3, H4: MountingHole_Pad; MountingHole_3.2mm_M3_DIN965_Pad
J11, J12, J13: Conn_Coaxial; U.FL_Hirose_U.FL-R-SMT-1_Vertical; PartNumber BWU.FL-IPEX1; not fitted
R132, R134: 0R; R_0402_1005Metric; not fitted
R133: 50R; R_0402_1005Metric; not fitted

Connections:
GND: FID1.1, FID2.1, FID3.1, H1.1 (1_1), H2.1 (1_1), H3.1 (1_1), H4.1 (1_1), J11.2 (Ext), J12.2 (Ext), J13.2 (Ext), R132.2, R133.2, R134.2; also elsewhere on the board
unnamed: J11.1 (In), R132.1
unnamed: J12.1 (In), R133.1
unnamed: J13.1 (In), R134.1

Notes on the sheet:
Calibration connectors

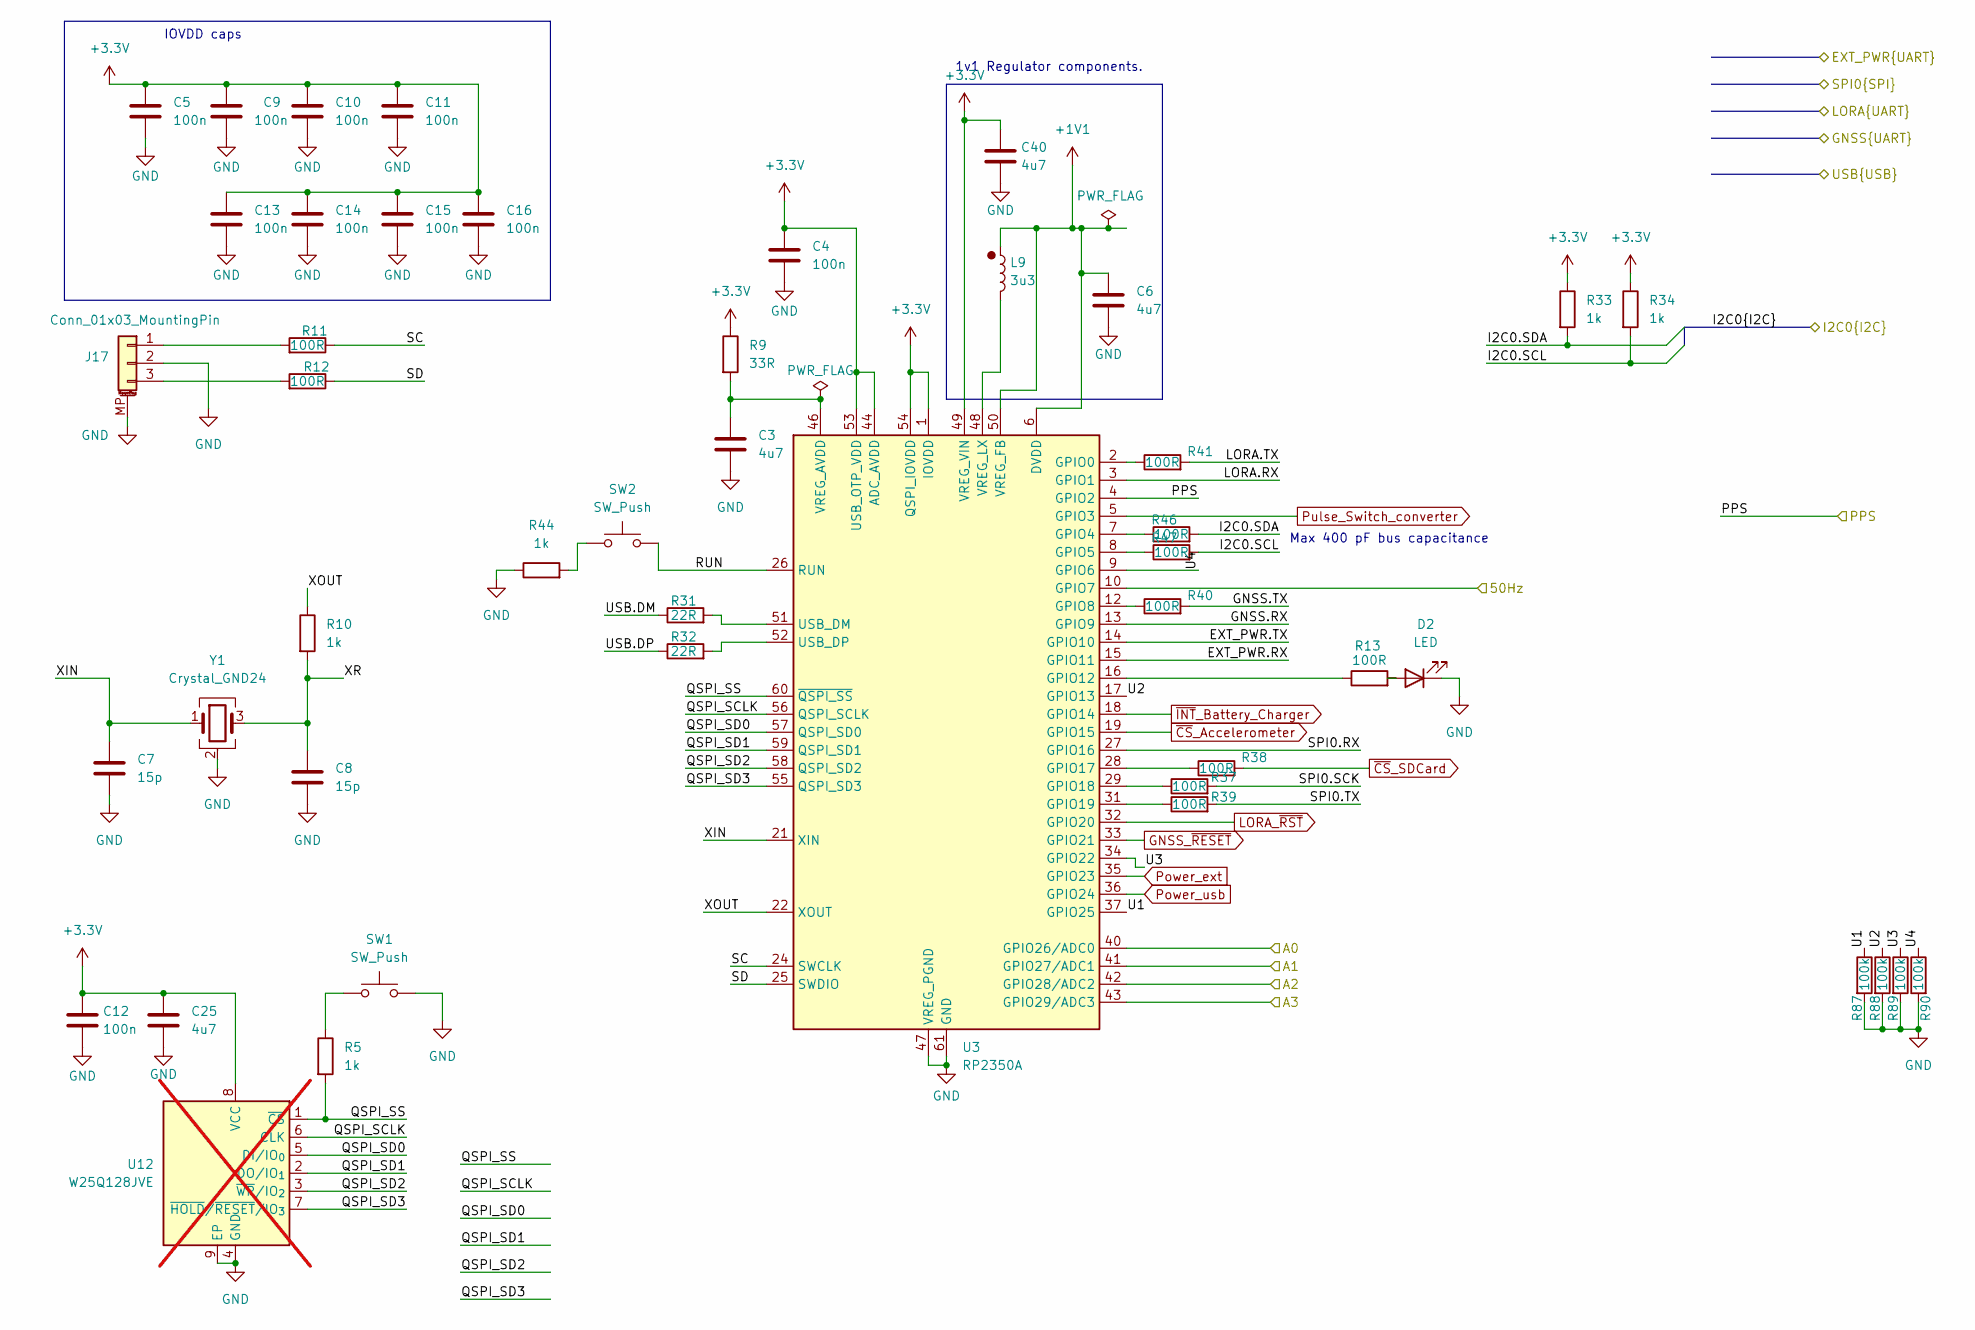
[picture p11: schematic RP_pico.kicad_sch]

Parts:
C3, C6, C25, C40: 4u7; C_0402_1005Metric; PartNumber CL05A475MP5NRNC
C4, C5, C9, C10, C11, C12, C13, C14, C15, C16: 100n; C_0402_1005Metric; PartNumber CL05B104KO5NNNC
C7, C8: 15p; C_0603_1608Metric; PartNumber CL10C150JB8NNNC
D2: LED; D_0603_1608Metric; PartNumber KT-0603R
J17: Conn_01x03_MountingPin; JST_SH_BM03B-SRSS-TB_1x03-1MP_P1.00mm_Vertical; PartNumber BM03B-SRSS-TB(LF)(SN)
L9: 3u3; AOTA-B201610S3R3-101-T; PartNumber AOTA-B201610S3R3-101-T
R5, R10, R33, R34, R44: 1k; R_0402_1005Metric; PartNumber 0402WGF1001TCE
R9: 33R; R_0402_1005Metric; PartNumber 0402WGF330JTCE
R11, R12, R13, R37, R38, R39, R40, R41, R46, R47: 100R; R_0402_1005Metric; PartNumber 0402WGF1000TCE
R31, R32: 22R; R_0402_1005Metric; PartNumber 0402WGF220JTCE
R87, R88, R89, R90: 100k; R_0402_1005Metric; PartNumber 0402WGF1003TCE
SW1, SW2: SW_Push; SW_SPST_EVQP2_ShortPushTravel_H2.1mm; PartNumber EVQP2T02M
U3: RP2350A; PartNumber RP2350A
U12: W25Q128JVE; W25Q; PartNumber W25Q128JVEIM; not fitted
Y1: Crystal_GND24; Crystal_SMD_3225-4Pin_3.2x2.5mm; PartNumber ABM8-272-T3

Connections:
+1V1: C6.1, L9.1, U3.6 (DVDD), U3.23 (DVDD), U3.39 (DVDD), U3.50 (VREG_FB)
+3.3V: C4.1, C5.1, C9.1, C10.1, C11.1, C12.1, C13.1, C14.1, C15.1, C16.1, C25.1, C40.1, R9.1, R33.1, R34.1, U3.1 (IOVDD), U3.11 (IOVDD), U3.20 (IOVDD), U3.30 (IOVDD), U3.38 (IOVDD), U3.44 (ADC_AVDD), U3.45 (IOVDD), U3.49 (VREG_VIN), U3.53 (USB_OTP_VDD), U3.54 (QSPI_IOVDD), U12.8 (VCC); also elsewhere on the board
/50Hz: U3.10 (GPIO7); also elsewhere on the board
/Celluar_GNSS/GNSS.RX: U3.13 (GPIO9); also elsewhere on the board
/Celluar_GNSS/GNSS.TX: R40.2; also elsewhere on the board
/Celluar_GNSS/PPS: U3.4 (GPIO2); also elsewhere on the board
/I2C0.SCL: R34.2, R47.2; also elsewhere on the board
/I2C0.SDA: R33.2, R46.2; also elsewhere on the board
/LORA/LORA.RX: U3.3 (GPIO1); also elsewhere on the board
/LORA/LORA.TX: R41.2; also elsewhere on the board
/Power/EXT_PWR.RX: U3.15 (GPIO11); also elsewhere on the board
/Power/EXT_PWR.TX: U3.14 (GPIO10); also elsewhere on the board
/Power/USB.DM: R31.1; also elsewhere on the board
/Power/USB.DP: R32.1; also elsewhere on the board
/RP_pico/A2: U3.42 (GPIO28/ADC2); also elsewhere on the board
/RP_pico/A3: U3.43 (GPIO29/ADC3); also elsewhere on the board
/RP_pico/QSPI_SCLK: U3.56 (QSPI_SCLK), U12.6 (CLK)
/RP_pico/QSPI_SD0: U3.57 (QSPI_SD0), U12.5 (DI/IO_{0})
/RP_pico/QSPI_SD1: U3.59 (QSPI_SD1), U12.2 (DO/IO_{1})
/RP_pico/QSPI_SD2: U3.58 (QSPI_SD2), U12.3 (~WP/IO_{2})
/RP_pico/QSPI_SD3: U3.55 (QSPI_SD3), U12.7 (~HOLD/~RESET/IO_{3})
/RP_pico/QSPI_SS: R5.2, U3.60 (~QSPI_SS), U12.1 (~CS)
/RP_pico/RUN: SW2.1, U3.26 (RUN)
/RP_pico/SC: R11.1, U3.24 (SWCLK)
/RP_pico/SD: R12.1, U3.25 (SWDIO)
/RP_pico/SPI0.RX: U3.27 (GPIO16); also elsewhere on the board
/RP_pico/SPI0.SCK: R37.2; also elsewhere on the board
/RP_pico/SPI0.TX: R39.2; also elsewhere on the board
/RP_pico/U1: R87.1, U3.37 (GPIO25)
/RP_pico/U2: R88.1, U3.17 (GPIO13)
/RP_pico/U3: R89.1, U3.34 (GPIO22)
/RP_pico/U4: R90.1, U3.9 (GPIO6)
/RP_pico/XIN: C7.1, U3.21 (XIN), Y1.1
/RP_pico/XOUT: R10.1, U3.22 (XOUT)
/RP_pico/XR: C8.1, R10.2, Y1.3
/hall effect sensor/Out: U3.41 (GPIO27/ADC1); also elsewhere on the board
/sens1: U3.40 (GPIO26/ADC0); also elsewhere on the board
GND: C3.2, C4.2, C5.2, C6.2, C7.2, C8.2, C9.2, C10.2, C11.2, C12.2, C13.2, C14.2, C15.2, C16.2, C25.2, C40.2, D2.1 (K), J17.2, J17.MP (MountPin), R44.1, R87.2, R88.2, R89.2, R90.2, SW1.1, U3.47 (VREG_PGND), U3.61 (GND), U12.4 (GND), U12.9 (EP), Y1.2 (G), Y1.4 (G); also elsewhere on the board
GNSS_~RESET: U3.33 (GPIO21); also elsewhere on the board
LORA_~RST: U3.32 (GPIO20); also elsewhere on the board
unnamed: D2.2 (A), R13.2
unnamed: J17.1, R11.2
unnamed: J17.3, R12.2
unnamed: R5.1, SW1.2
unnamed: R44.2, SW2.2
unnamed: R41.1, U3.2 (GPIO0)
unnamed: R46.1, U3.7 (GPIO4)
unnamed: R47.1, U3.8 (GPIO5)
unnamed: R40.1, U3.12 (GPIO8)
unnamed: R13.1, U3.16 (GPIO12)
unnamed: R38.1, U3.28 (GPIO17)
unnamed: R37.1, U3.29 (GPIO18)
unnamed: R39.1, U3.31 (GPIO19)
unnamed: R31.2, U3.51 (USB_DM)
unnamed: R32.2, U3.52 (USB_DP)
unnamed: C3.1, R9.2, U3.46 (VREG_AVDD)
unnamed: L9.2, U3.48 (VREG_LX)
Power_ext: U3.35 (GPIO23); also elsewhere on the board
Power_usb: U3.36 (GPIO24); also elsewhere on the board
Pulse_Switch_converter: U3.5 (GPIO3); also elsewhere on the board
~CS_Accelerometer: U3.19 (GPIO15); also elsewhere on the board
~CS_SDCard: R38.2; also elsewhere on the board
~INT_Battery_Charger: U3.18 (GPIO14); also elsewhere on the board

Notes on the sheet:
IOVDD caps
Max 400 pF bus capacitance
1v1 Regulator components.

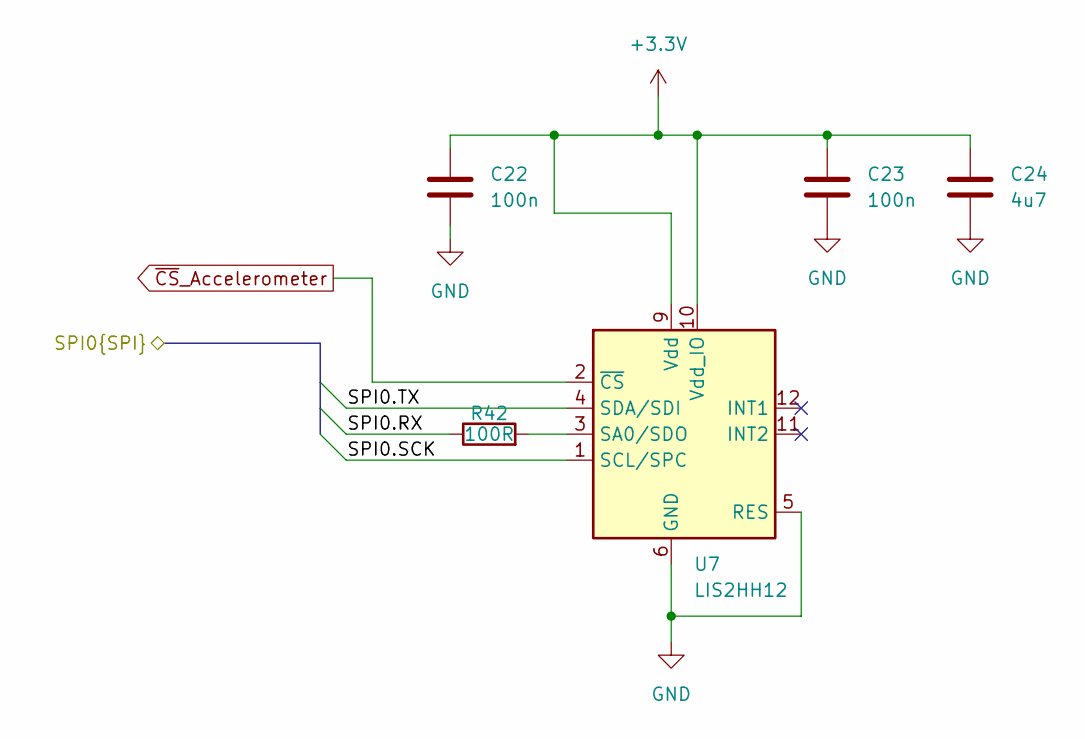
[picture p12: schematic accelerometer.kicad_sch]

Parts:
C22, C23: 100n; C_0402_1005Metric; PartNumber CL05B104KO5NNNC
C24: 4u7; C_0402_1005Metric; PartNumber CL05A475MP5NRNC
R42: 100R; R_0402_1005Metric; PartNumber 0402WGF1000TCE
U7: LIS2HH12; LGA-12_2x2mm_P0.5mm; PartNumber LIS2HH12

Connections:
+3.3V: C22.1, C23.1, C24.1, U7.9 (Vdd), U7.10 (Vdd_IO); also elsewhere on the board
/RP_pico/SPI0.RX: R42.1; also elsewhere on the board
/RP_pico/SPI0.SCK: U7.1 (SCL/SPC); also elsewhere on the board
/RP_pico/SPI0.TX: U7.4 (SDA/SDI); also elsewhere on the board
GND: C22.2, C23.2, C24.2, U7.5 (RES), U7.6 (GND), U7.7 (GND), U7.8 (GND); also elsewhere on the board
unnamed: R42.2, U7.3 (SA0/SDO)
~CS_Accelerometer: U7.2 (~CS); also elsewhere on the board

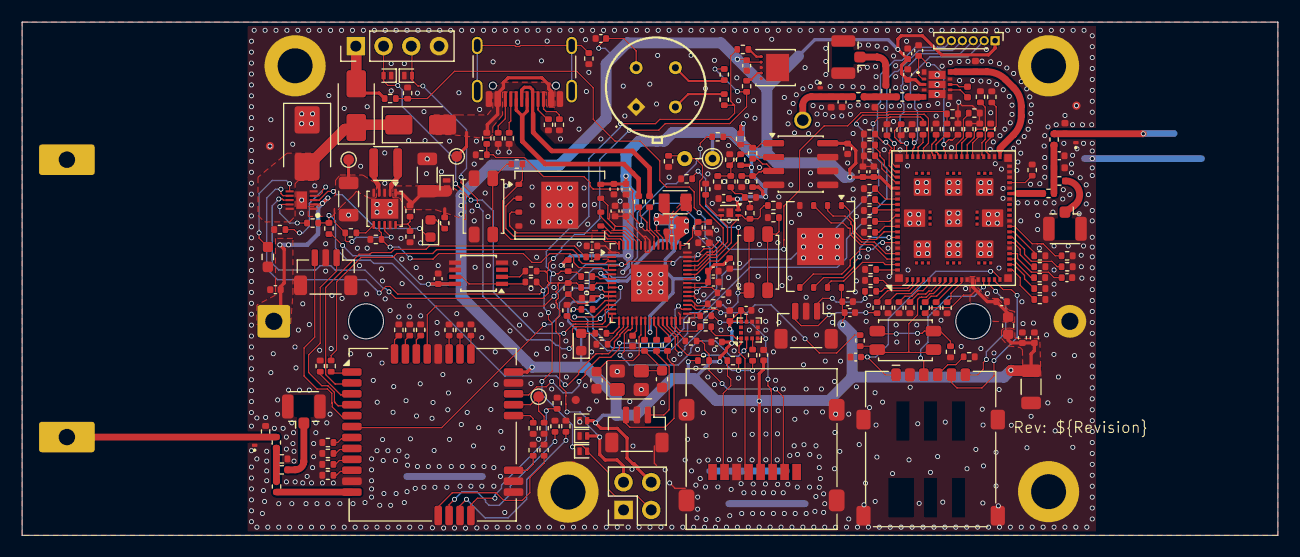
[picture p13: board PowerLineSensorPCB.kicad_pcb from above]

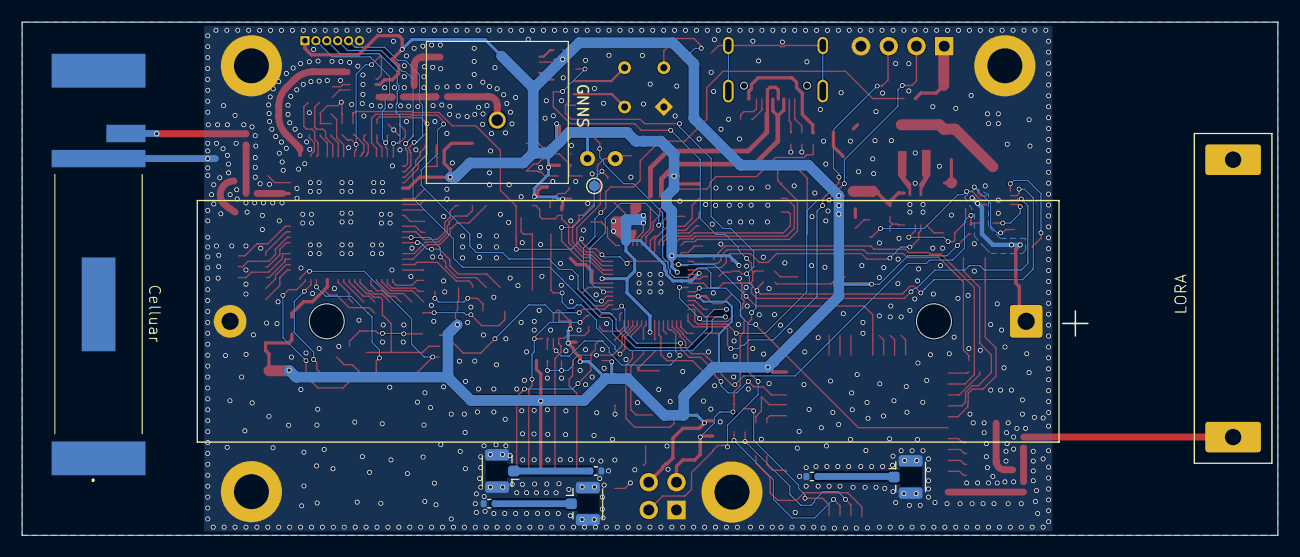
[picture p14: board PowerLineSensorPCB.kicad_pcb from below]

Board: 4 copper layers, 115.0 x 47.0 mm, 255 parts (11 on the bottom side), 189 nets.
