BecsterAS/PowerLineSensorPCB/(commit log)

2026-06-29 initial PCB
    [GNSS.kicad_sch, LORA.kicad_sch, PCB_temp_sensor.kicad_sch, PowerLineSensorPCB.kicad_pcb, PowerLineSensorPCB.kicad_sch, RP_pico.kicad_sch, SD_card.kicad_sch, USB_Power.kicad_sch]
2026-06-29 update kicadlib
2026-07-04 Update PowerLineSensorPCB and nRF9151 schematic with designator adjustments and new GND symbol
    - Modified the used designators in PowerLineSensorPCB to include an additional power reference.
    - Renamed the sheet in PowerLineSensorPCB for clarity.
    - Removed unnecessary junctions and adjusted wire connections in nRF9151 schematic for improved layout.
    - Added a new GND symbol in nRF9151 schematic to create a global label for ground.
    - Adjusted positions of several components and properties for better alignment and readability.
    - Updated subproject commit reference for kicad-libs.
    [PowerLineSensorPCB.kicad_pcb, nRF9151.kicad_sch]
2026-07-05 Update schematic components and properties across multiple files
    - Changed capacitor values from "4.7u" to "4u7" and updated footprints from "C_0402_1005Metric" to "C_1206_3216Metric" in accelerometer.kicad_sch and nRF9151.kicad_sch.
    - Updated part numbers for capacitors in accelerometer.kicad_sch and nRF9151.kicad_sch.
    - Added a new resistor (R99) with value "100R" in hall_effect_sensor.kicad_sch.
    - Removed unnecessary junctions in nRF9151.kicad_sch and adjusted wire connections.
    - Added properties for MLX90637 and ZTPD2210 sensors in temp_sensors.kicad_sch.
    [LORA.kicad_sch, PCB_temp_sensor.kicad_sch, PowerLineSensorPCB.kicad_sch, USB_Power.kicad_sch, accelerometer.kicad_sch, hall_effect_sensor.kicad_sch, nRF9151.kicad_sch, temp_sensors.kicad_sch]
2026-07-05 Update kicad-libs subproject to latest commit
2026-07-06 general improvments
    [PCB_temp_sensor.kicad_sch, PowerLineSensorPCB.kicad_pcb, PowerLineSensorPCB.kicad_sch, temp_sensors.kicad_sch]
2026-07-06 PCB routing.
    Add netclass flags for power and signal in various schematics; update capacitor footprints and part numbers
    - Introduced multiple netclass flags for "Power" and "Signal" in USB_Power, hall_effect_sensor, and nRF9151 schematics to enhance clarity and organization.
    - Updated capacitor footprints from "C_1206_3216Metric" to "C_0402_1005Metric" and part numbers from "1206B475K500NT" to "CL05A475MP5NRNC" in accelerometer and nRF9151 schematics for consistency and accuracy.
    - Updated submodule reference in kicad-libs to ensure compatibility with the latest library changes.
    [PowerLineSensorPCB.kicad_pcb, PowerLineSensorPCB.kicad_sch, RP_pico.kicad_sch, USB_Power.kicad_sch, accelerometer.kicad_sch, hall_effect_sensor.kicad_sch, nRF9151.kicad_sch]
2026-07-07 pcb edits. remove old backups
    [PowerLineSensorPCB.kicad_pcb, PowerLineSensorPCB.kicad_sch, RP_pico.kicad_sch, USB_Power.kicad_sch, hall_effect_sensor.kicad_sch, miscellaneous.kicad_sch, nRF9151.kicad_sch]
2026-07-08 PCB development!!
    Update submodule and add script for selecting non-GND vias
    - Updated kicad-libs submodule to the latest commit.
    - Added a new script `select_all_non_gnd_vias.py` to select all vias not connected to ground nets.
    - Updated references in nRF9151 schematic from "IC1" to "U14" and from "AE1" to "ANT2".
    - Modified temp_sensors schematic to add a hidden power input pin and adjusted component properties.
    [GNSS.kicad_sch, LORA.kicad_sch, PCB_temp_sensor.kicad_sch, PowerLineSensorPCB.kicad_pcb, PowerLineSensorPCB.kicad_sch, RP_pico.kicad_sch, SD_card.kicad_sch, USB_Power.kicad_sch]
2026-07-09 PCB updates
    Update miscellaneous.kicad_sch to add new fiducial symbol and replace existing fiducial references
    - Added a new fiducial symbol "BC_Miscellaneous:Fiducial" with ground
    - Updated references in the schematic to point to the new fiducial symbol.
    - Changed the DNP (Do Not Place) property for components U13 and U6 from 'no' to 'yes' to prevent placement on the PCB.
    - Updated the footprint property for U13 to "BC_Memory:W25Q" to reflect the correct component footprint.
    [LORA.kicad_sch, PowerLineSensorPCB.kicad_pcb, RP_pico.kicad_sch, USB_Power.kicad_sch, miscellaneous.kicad_sch, nRF9151.kicad_sch]
2026-07-10 Update subproject reference for kicad-libs to latest commit fe3e1e7
    [PowerLineSensorPCB-B_Cu.gbr, PowerLineSensorPCB-B_Mask.gbr, PowerLineSensorPCB-B_Paste.gbr, PowerLineSensorPCB-B_Silkscreen.gbr, PowerLineSensorPCB-Edge_Cuts.gbr, PowerLineSensorPCB-F_Cu.gbr, PowerLineSensorPCB-F_Fab.gbr, PowerLineSensorPCB-F_Mask.gbr]
2026-07-13 pcb updates
    [PowerLineSensorPCB.kicad_pcb]
2026-07-15 send to production. v0.1, making jobset for export
    [LORA.kicad_sch, PCB_temp_sensor.kicad_sch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]
